EdrickOliveira/softstarter/README.md

# Soft Starter - V0.6.0
By Davi da Silva Schuch and Edrick Thomé de Oliveira \
Eletrônica de Potência e Processamento de Sinais - Prof. Irineu A. Ronconi Jr.

## Documentation and Progress
- [Zero Detector](docs/zeroDetector/) 
    - [Zero Detector Test](docs/zeroDetector/zeroDetector%20test/)
    - [Zero Detector Fix](docs/zeroDetector/zeroDetector%20fix/README.md) 
- [Trigger](docs/trigger/)
    - [Calculation](docs/trigger/triggerAngle%20calculation/README.md)
    - [Test](docs/trigger/triggerPulse%20test/README.md)
- [0.0.0-waveModulation](docs/0.0.0-waveModulation/README.md)
- [0.1.0-standardControl](docs/0.1.0-standardControl/README.md)
- [0.1.1-inductiveLayout](docs/0.1.1-inductiveLayout/README.md)
- [0.1.2-motorAtNeutral](docs/0.1.2-motorAtNeutral/README.md)
- [0.1.3-minecraftsLayout](docs/0.1.3-minecraftsLayout/README.md)
- [0.2.0-newTriac](docs/0.2.0-newTriac/README.md)
- [0.2.1-inductiveAgain](docs/0.2.1-inductiveAgain/README.md)
- [0.2.2-universalBack](docs/0.2.2-universalBack/README.md)
    - [extensionFixAttempt](docs/extensionFixAttempt/README.md)
- [0.2.3-pwm](docs/0.2.3-pwm/README.md)
- [0.3.0-setPowerRatio](docs/0.3.0-setPowerRatio/README.md)
- [0.3.1-speedRatio](docs/0.3.1-speedRatio/README.md)
- [0.3.2-loopMenu](docs/0.3.2-loopMenu/README.md)
- [0.4.0-rampSettings](docs/0.4.0-rampSettings/README.md)
- [0.4.1-softstarting](docs/0.4.1-softstarting/README.md)
- [0.5.0-currentMeasurement](docs/0.5.0-currentMeasurement/README.md)
- [0.5.1-ina226](docs/0.5.1-ina226/README.md)
- [0.5.2-currentTransformer](docs/0.5.2-currentTransformer/README.md)
- [0.5.3-alerts](docs/0.5.3-alerts/README.md)
- [0.5.4-overcurrentProtection](docs/0.5.4-overcurrentProtection/README.md)
- [0.6.0-phaseDetection](docs/0.6.0-phaseDetection/README.md)
