EdrickOliveira/softstarter/docs/0.4.1-softstarting/README.md

# softstarting

The "startRamp" function has been developed, so that the user can start the motor according to the ramps settings.

The console displays the current state (rising - full - falling - off).
