EdrickOliveira/softstarter/docs/0.3.2-loopMenu/README.md

# loopMenu

Now the menu is inside the while loop.

This version allows the user to set the Power Ratio sequentially, without having to restart the microcontroller.
