EdrickOliveira/softstarter/docs/0.1.1-inductiveLayout/Vae&Vde_0.JPG

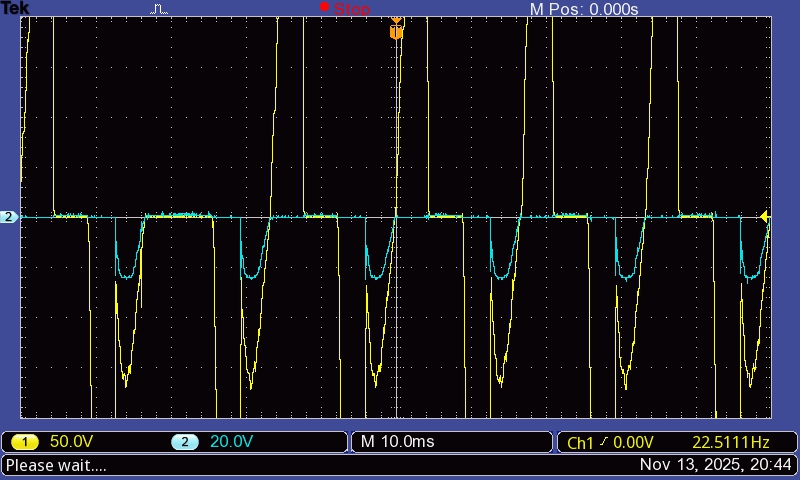
docs/0.1.1-inductiveLayout/Vae&Vde_0.JPG
