EdrickOliveira/softstarter/docs/0.1.1-inductiveLayout/Vae&Vde_1.JPG

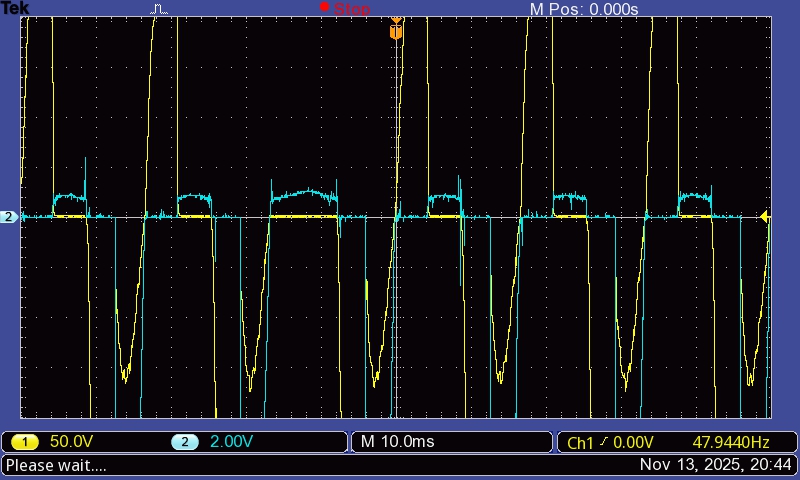
docs/0.1.1-inductiveLayout/Vae&Vde_1.JPG
