EdrickOliveira/softstarter/docs/0.1.1-inductiveLayout/Vmotor.JPG

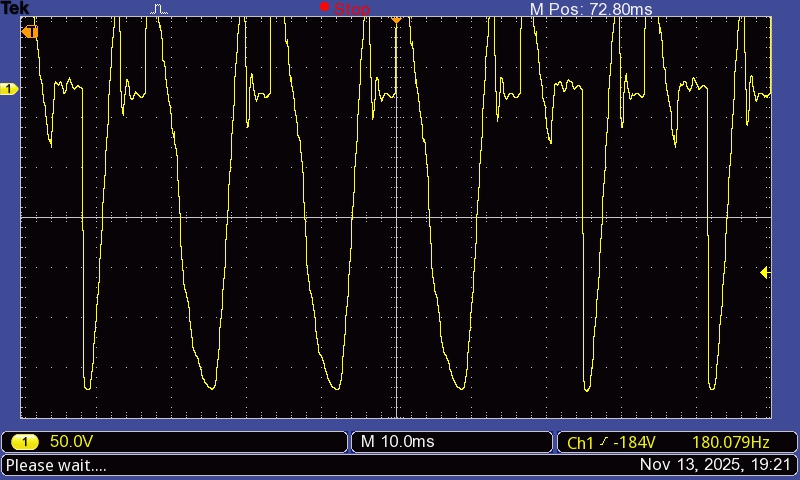
docs/0.1.1-inductiveLayout/Vmotor.JPG
