EdrickOliveira/softstarter/docs/0.2.1-inductiveAgain/Vae.JPG

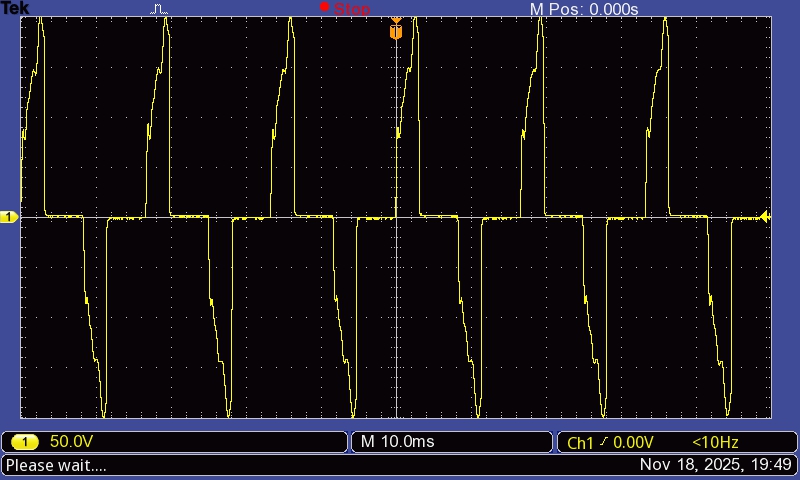
docs/0.2.1-inductiveAgain/Vae.JPG
