EdrickOliveira/softstarter/docs/0.2.1-inductiveAgain/Vra&Vea_0.JPG

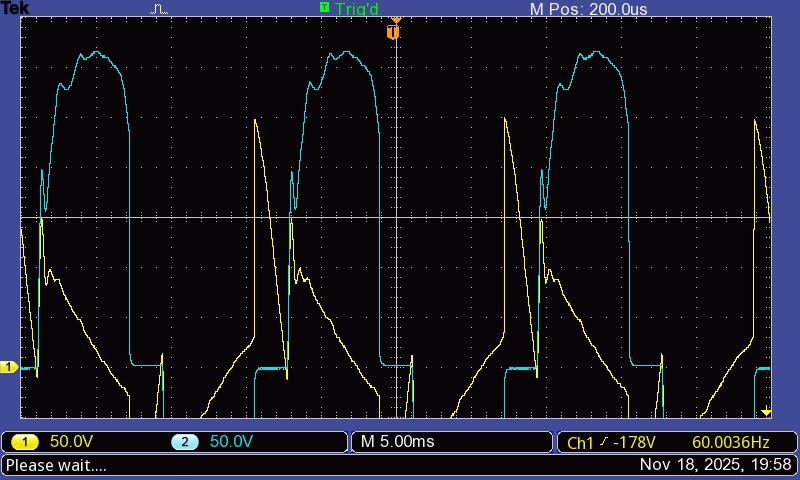
docs/0.2.1-inductiveAgain/Vra&Vea_0.JPG
