EdrickOliveira/softstarter/docs/0.2.1-inductiveAgain/Vra&Vea_1.JPG

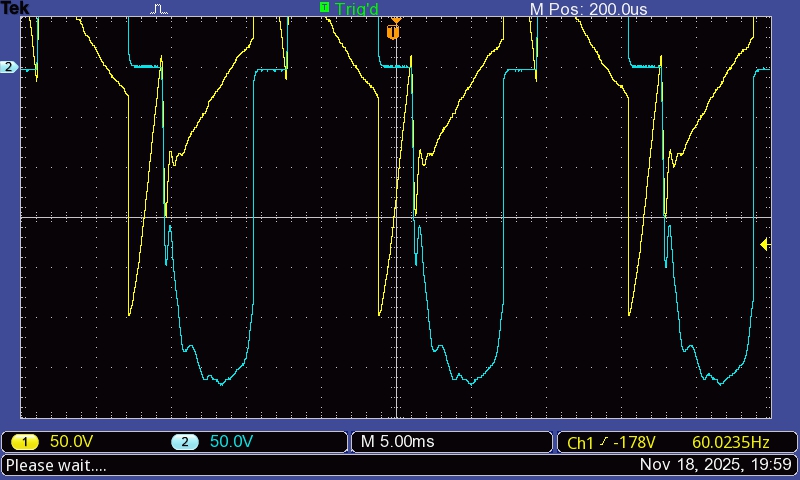
docs/0.2.1-inductiveAgain/Vra&Vea_1.JPG
