EdrickOliveira/softstarter/docs/0.2.1-inductiveAgain/Vra.JPG

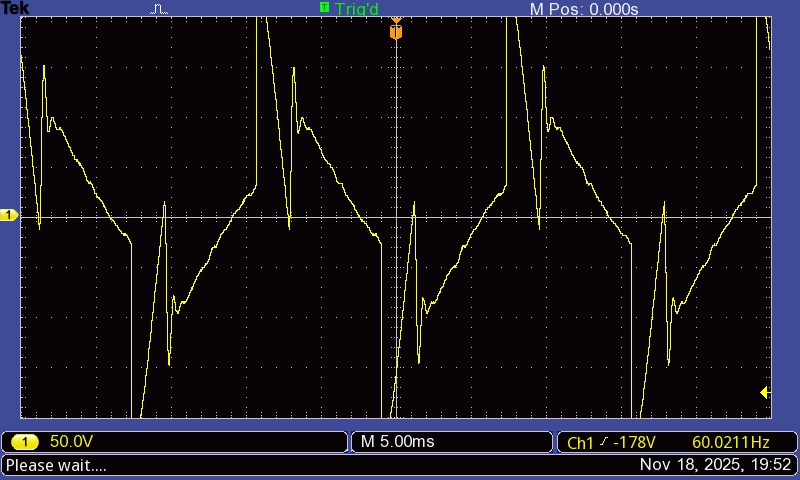
docs/0.2.1-inductiveAgain/Vra.JPG
