EdrickOliveira/softstarter/docs/0.2.3-pwm/pwmGap.JPG

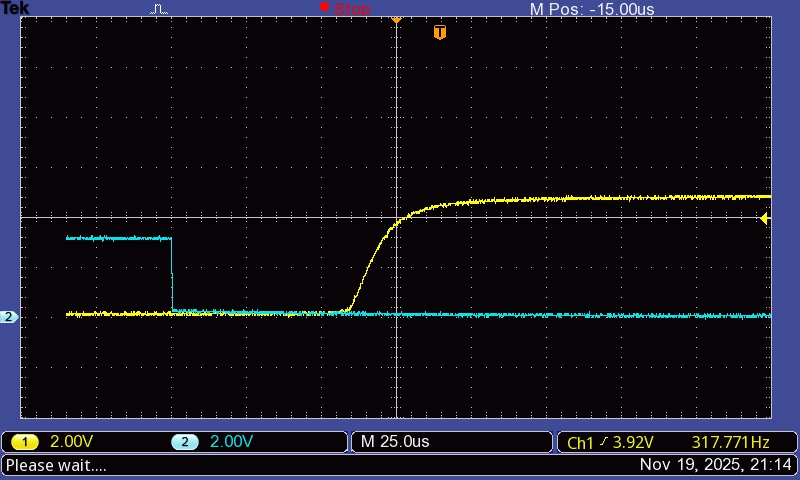
docs/0.2.3-pwm/pwmGap.JPG
