EdrickOliveira/softstarter/docs/0.2.3-pwm/pwmZoomIn.JPG

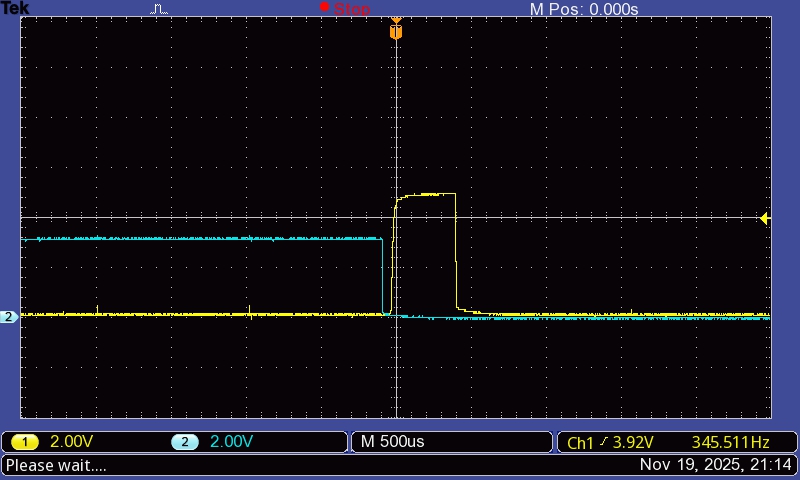
docs/0.2.3-pwm/pwmZoomIn.JPG
