EdrickOliveira/softstarter/docs/0.5.0-currentMeasurement/README.md

# currentMeasurement

In order to build the overcurrent protection circuit, the first step was to measure the current through the motor. The method used was with a shunt resistor:

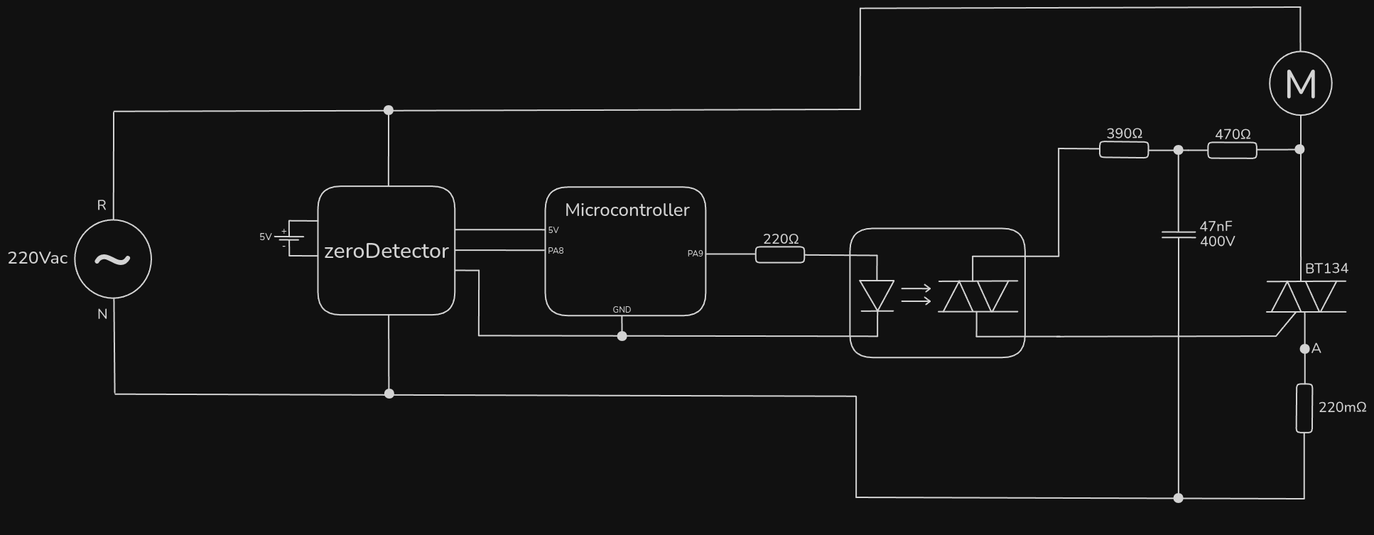
[picture p77: docs/0.5.0-currentMeasurement/diagram.png]


## Results

The $V_{AN}$ was measured for different $S_r$ values:

### $S_r=10\%$

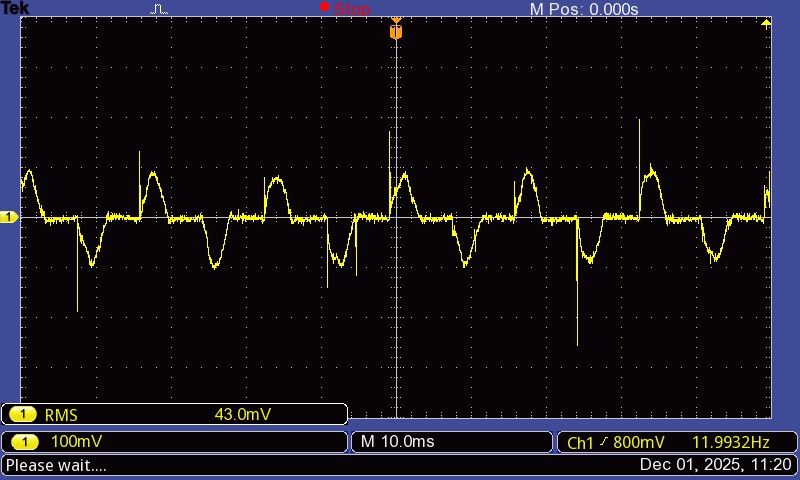
[picture p78: docs/0.5.0-currentMeasurement/Sr_10.JPG]


### $S_r=20\%$

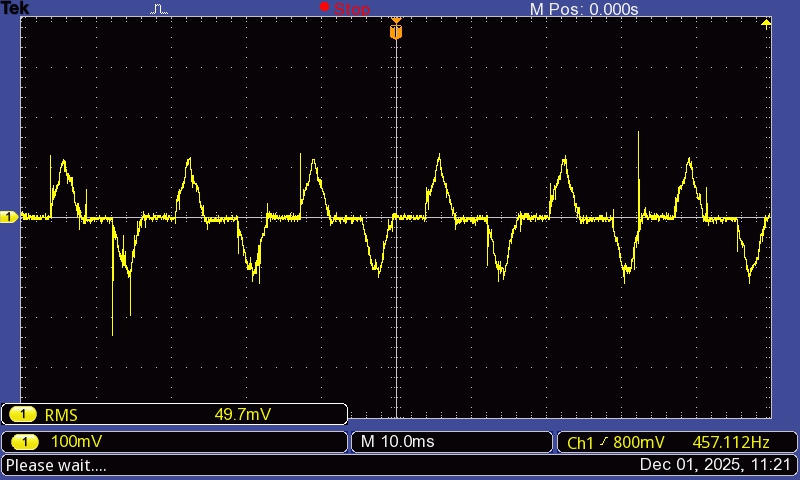
[picture p79: docs/0.5.0-currentMeasurement/Sr_20.JPG]


### $S_r=30\%$

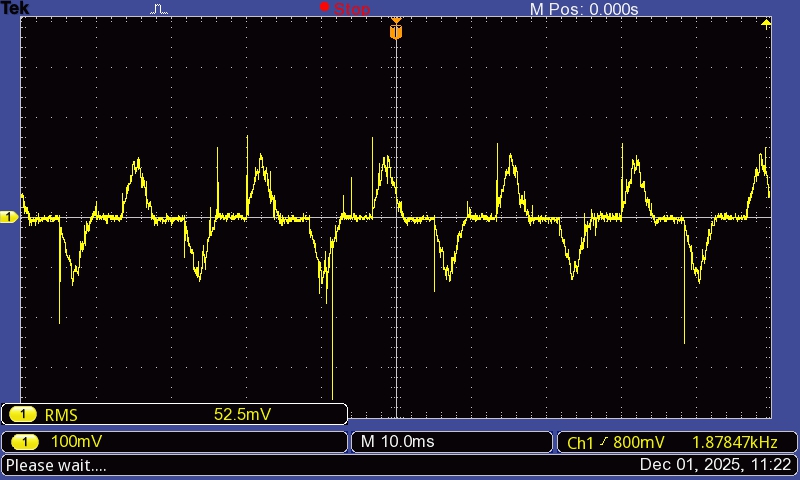
[picture p80: docs/0.5.0-currentMeasurement/Sr_30.JPG]


### $S_r=50\%$

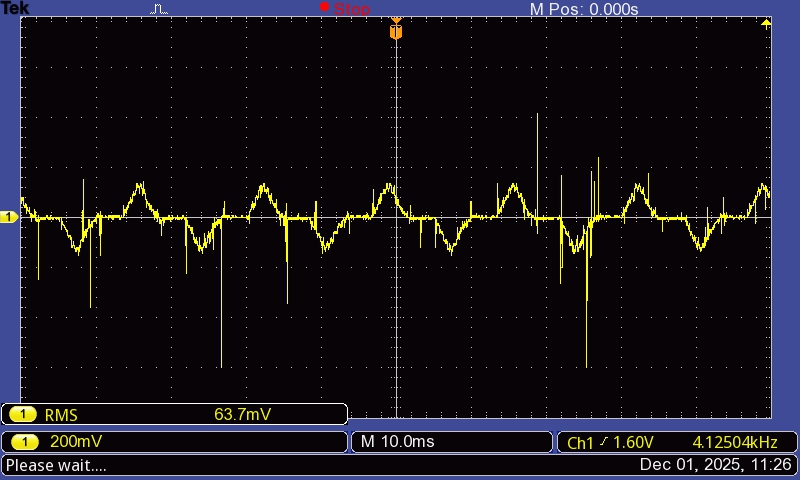
[picture p81: docs/0.5.0-currentMeasurement/Sr_50.JPG]


### $S_r=70\%$

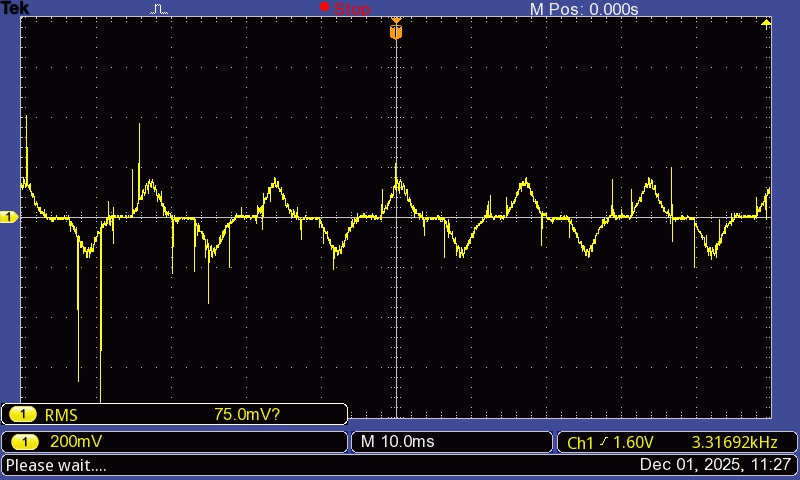
[picture p82: docs/0.5.0-currentMeasurement/Sr_70.JPG]


### $S_r=100\%$

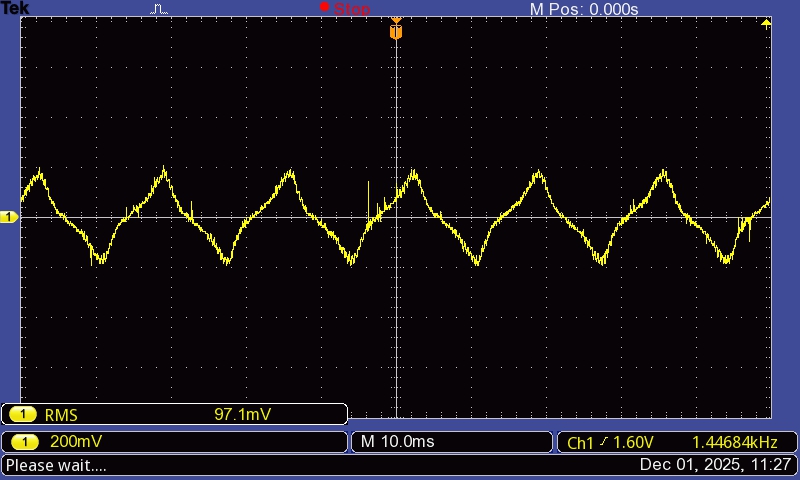
[picture p83: docs/0.5.0-currentMeasurement/Sr_100.JPG]


### $S_r=100\%; I=1.5I_{typ}$

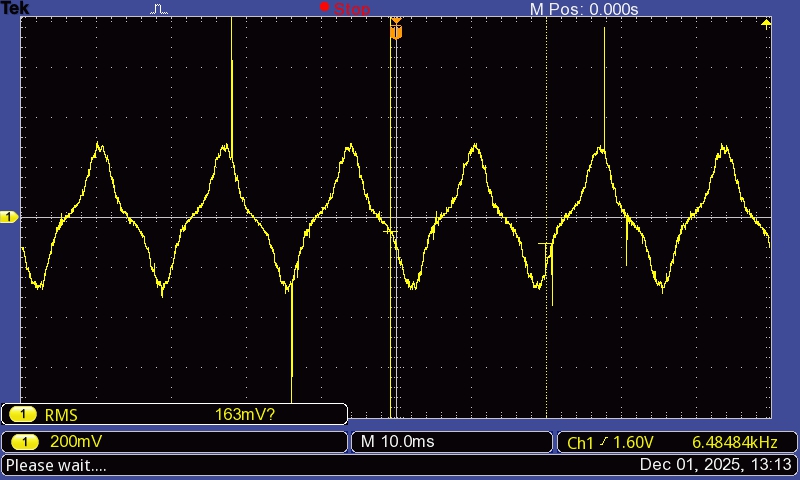
[picture p84: docs/0.5.0-currentMeasurement/1.5I.JPG]

$V_{shunt_{peak}}=360mV$

### $S_r=100\%; I=2I_{typ}$

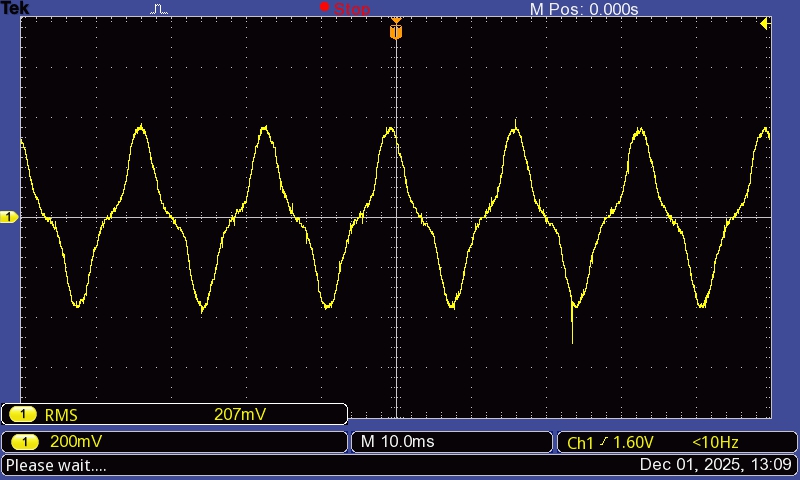
[picture p85: docs/0.5.0-currentMeasurement/2I.JPG]

$V_{shunt_{peak}}=280mV$

## Discussion

If we can measure the current discretely frequently enough, we can just check if it's greater than a desired threshold to take action.

The typical motor current is $500mA$. The system has to shut down if it's more than $1A$, or pull the trigger back if more than $750mA$ ($2\cdot I_{typ}$ ; $1.5\cdot I_{typ}$ - project criteria).
