EdrickOliveira/softstarter/docs/trigger/triggerPulse test/triggerPulse - zoom in.JPG

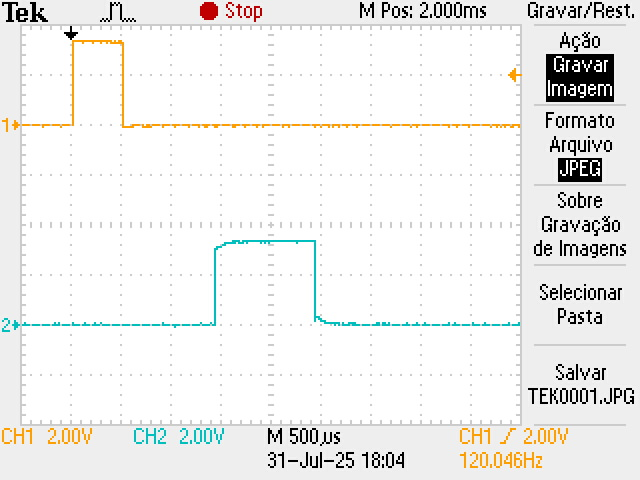
docs/trigger/triggerPulse test/triggerPulse - zoom in.JPG
