EdrickOliveira/softstarter/docs/trigger/triggerPulse test/triggerPulse - zoom out.JPG

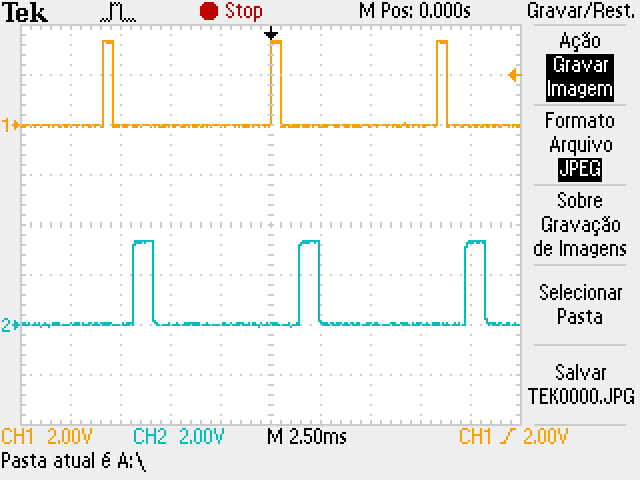
docs/trigger/triggerPulse test/triggerPulse - zoom out.JPG
