EdrickOliveira/softstarter/docs/zeroDetector/zeroDetector test/circuit.png

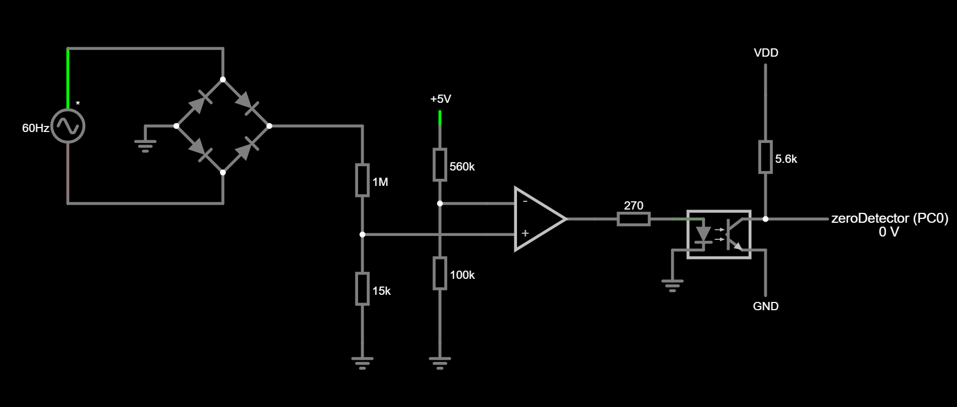
docs/zeroDetector/zeroDetector test/circuit.png
