EdrickOliveira/softstarter/docs/zeroDetector/zeroDetector test/pin (PC1).JPG

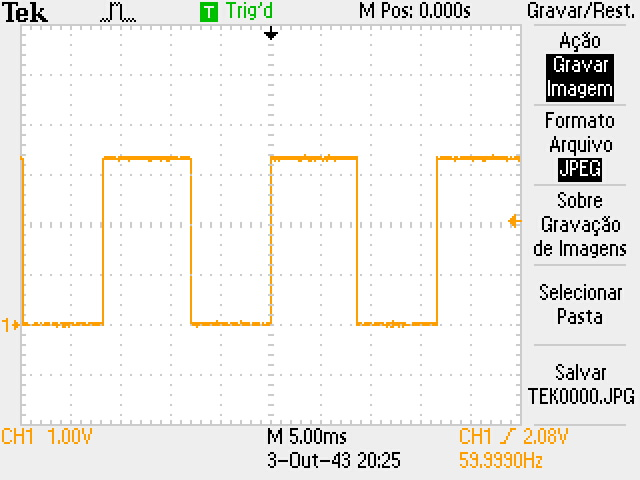
docs/zeroDetector/zeroDetector test/pin (PC1).JPG
