EdrickOliveira/softstarter/Core/Src/main.c

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
/* Includes ------------------------------------------------------------------*/
#include "main.h"

/* USER CODE BEGIN Includes */
#include "math.h"
#include "powerToAngle.h"
/* USER CODE END Includes */

/* USER CODE BEGIN PTD */
typedef struct{
	//rising and falling times in seconds
	int risingTime;
	int fallingTime;
}ramps_t;
/* USER CODE END PTD */

/* USER CODE BEGIN PD */
#define PULSE_WIDTH 1000	//pulse width in TIM1's clock pulses (ARR = 58100)
#define TRIGGER_ARR 58100
#define RX_BUFFER_SIZE 4
/* USER CODE END PD */

TIM_HandleTypeDef htim1;
TIM_HandleTypeDef htim10;
TIM_HandleTypeDef htim11;

UART_HandleTypeDef huart2;
DMA_HandleTypeDef hdma_usart2_rx;

/* USER CODE BEGIN PV */
ramps_t ramps;
uint32_t time_ms = 0;		//stopwatch

uint32_t triggerCCR;

uint8_t rx;				//byte received from UART
uint8_t rxBuffer[RX_BUFFER_SIZE];	//stores data received from UART
uint8_t rxFlag = 0;		//flips to 1 when DMA request is complete (a message has been received)
uint8_t inputSize;	//the size of the next expected input

uint8_t alertsEnabled = 0;
uint8_t alertFlag = 0;	// 0 = no alert; 1 = slow alert; 2 = stop alert
uint32_t stopAlertCounter = 0;
uint32_t slowAlertCounter = 0;

uint8_t phaseUp = 0;	//0 - phase is down/off; 1 - phase is up (220V)
/* USER CODE END PV */

void SystemClock_Config(void);
static void MX_GPIO_Init(void);
static void MX_DMA_Init(void);
static void MX_TIM1_Init(void);
static void MX_USART2_UART_Init(void);
static void MX_TIM10_Init(void);
static void MX_TIM11_Init(void);
/* USER CODE BEGIN PFP */
void menu();
void setPr();
void startRamp();
void rampSettings();
void setRampTime(int *rampTime);
void overcurrent();
void phaseDown();

void setTriggerCCR(uint32_t newTrigger);

void clearRxBuffer();
void appendRxBuffer(uint8_t data);
void backspaceRxBuffer();
char isInputComplete();
int extractNumber();	//convert the byte sequence buffer (number written in ASCII) to integer
void receiveInput(int size);

int len(uint8_t *s);	//returns the length of a string
/* USER CODE END PFP */

/**
  * @brief  The application entry point.
  * @retval int
  */
int main(void)
{

  /* MCU Configuration--------------------------------------------------------*/

  /* Reset of all peripherals, Initializes the Flash interface and the Systick. */
  HAL_Init();

  /* Configure the system clock */
  SystemClock_Config();

  /* Initialize all configured peripherals */
  MX_GPIO_Init();
  MX_DMA_Init();
  MX_TIM1_Init();
  MX_USART2_UART_Init();
  MX_TIM10_Init();
  MX_TIM11_Init();
  /* USER CODE BEGIN 2 */
  triggerCCR = TIM1->CCR2;	//initialize triggerCCR variable
  setTriggerCCR(TRIGGER_ARR);

  HAL_TIM_PWM_Start(&htim1, TIM_CHANNEL_2);	//start trigger PWM

  HAL_TIM_Base_Start_IT(&htim11);	//start phase detection

  //clear buffer and start listening to UART
  clearRxBuffer();
  HAL_UART_Receive_DMA(&huart2, &rx, 1);

  /* USER CODE END 2 */

  /* Infinite loop */
  /* USER CODE BEGIN WHILE */
  while (1)
  {
	  if(!alertFlag)			menu();			//go to menu if everything's alright
	  else if(alertFlag == 2)	overcurrent();	//overcurrent protocol if stopAlert triggers
    /* USER CODE END WHILE */

    /* USER CODE BEGIN 3 */
  }
  /* USER CODE END 3 */
}

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
/* USER CODE BEGIN 4 */
void menu(){
	uint8_t message[] = {"\r\n\nCommands:\n\r\t'P': set power ratio\n\r\t'S': start ramp\n\r\t'R': ramp settings\n\rType the command: "};

	HAL_UART_Transmit(&huart2, message, len(message), HAL_MAX_DELAY);	//print menu and prompt
	receiveInput(1);	//1 byte long input expected

	switch(rxBuffer[0]){
	case 'p':
		setPr();
		break;
	case 's':
		startRamp();
		break;
	case 'r':
		rampSettings();
		break;
	}
}

void setPr(){
	uint8_t message[] = {"\r\n\nInsert desired Power Ratio (in percentage): "};
	float Pr, Sr, triggerAngle;
	uint16_t triggerCCR;

	HAL_UART_Transmit(&huart2, message, len(message), HAL_MAX_DELAY);	//print prompt
	receiveInput(3);	//3 bytes long input expected

	Sr = (float)extractNumber()/100;
	Pr = speedToPower(Sr);
	triggerAngle = getTrigger(Pr);
	triggerCCR = (uint16_t)angleToCCR(triggerAngle, TRIGGER_ARR);
	setTriggerCCR(triggerCCR);
}

void startRamp(){
	uint8_t risingMsg[] = {"\r\n\nRising ramp started"};
	uint8_t fullPowerMsg[] = {"\r\nFull power\r\nType 'enter' to start falling ramp"};
	uint8_t fallingMsg[] = {"\r\nFalling ramp started"};
	uint8_t offMsg[] = {"\r\nMotor is off"};
	float Pr, Sr, triggerAngle, time_s;
	uint16_t triggerCCR;

	HAL_UART_Transmit(&huart2, risingMsg, len(risingMsg), HAL_MAX_DELAY);	//print that rising has begun

	alertsEnabled = 1;	//enable overcurrent alerts

	//rising ramp
	HAL_TIM_Base_Start_IT(&htim10);	//start stopwatch
	do{
		//execute phase down protocol
		if(!phaseUp){
			phaseDown();
			return;
		}

		time_s = ((float)(time_ms))/1000;

		//constantly update trigger angle according to the stopwatch, if there is no active alert
		if(!alertFlag){
			Sr = ((float)time_s)/ramps.risingTime;	//percentage of time elapsed (100% is the rising time) is the SpeedRatio
			Pr = speedToPower(Sr);
			triggerAngle = getTrigger(Pr);
			triggerCCR = (uint16_t)angleToCCR(triggerAngle, TRIGGER_ARR);
			setTriggerCCR(triggerCCR);
		}
		//slow down (go back in time) if slowAlert triggers
		else if(alertFlag == 1){
			if(time_ms-200*ramps.risingTime >= 0)	time_ms -= 200*ramps.risingTime;
			else									time_ms = 0;
			alertFlag = 0;
		}
		//execute overcurrent protocol if stopAlert triggers
		else if(alertFlag==2){
			return;
		}
	}while(time_s<ramps.risingTime);	//stop when rising time is complete
	HAL_TIM_Base_Stop_IT(&htim10);
	time_ms = 0;

	HAL_UART_Transmit(&huart2, fullPowerMsg, len(fullPowerMsg), HAL_MAX_DELAY);	//print full power indicator
	receiveInput(1);	//wait for any user input

	if(alertFlag == 2){
		return;
	}

	HAL_UART_Transmit(&huart2, fallingMsg, len(fallingMsg), HAL_MAX_DELAY);	//print that falling has begun

	//falling ramp
	HAL_TIM_Base_Start_IT(&htim10);	//start stopwatch
	do{
		//execute phase down protocol
		if(!phaseUp){
			phaseDown();
			return;
		}

		time_s = ((float)(time_ms))/1000;

		//constantly update trigger angle according to the stopwatch
		Sr = ((float)(ramps.fallingTime-time_s))/ramps.fallingTime;	//percentage of time remaining to falling time is the SpeedRatio
		Pr = speedToPower(Sr);
		triggerAngle = getTrigger(Pr);
		triggerCCR = (uint16_t)angleToCCR(triggerAngle, TRIGGER_ARR);
		setTriggerCCR(triggerCCR);
	}while(time_s<ramps.fallingTime);
	HAL_TIM_Base_Stop_IT(&htim10);
	time_ms = 0;

	HAL_UART_Transmit(&huart2, offMsg, len(offMsg), HAL_MAX_DELAY);	//print that motor is off

	alertsEnabled = 0;	//disable overcurrent alerts
}

void rampSettings(){
	uint8_t message[] = {"\r\n\nRising ramp ('R')\n\rFalling ramp ('F')\n\rSelect an option: "};

	HAL_UART_Transmit(&huart2, message, len(message), HAL_MAX_DELAY);
	receiveInput(1);	//1 byte long input expected

	switch(rxBuffer[0]){
	case 'r':
		setRampTime(&(ramps.risingTime));
		break;
	case 'f':
		setRampTime(&(ramps.fallingTime));
		break;
	}
}

void setRampTime(int *rampTime){
	uint8_t message[] = {"\r\nInsert ramp time in seconds (max 3 digits): "};

	HAL_UART_Transmit(&huart2, message, len(message), HAL_MAX_DELAY);
	receiveInput(3);	//3 bytes long input expected

	*rampTime = extractNumber();
}

void overcurrent(){
	uint8_t overcurrentMsg[] = {"\r\nOvercurrent - process aborted"};

	setTriggerCCR(TRIGGER_ARR);	//turn motor off
	HAL_TIM_Base_Stop(&htim10);	//turn ramp timer off
	time_ms = 0;				//reset ramp time counter

	HAL_UART_Transmit(&huart2, overcurrentMsg, len(overcurrentMsg), HAL_MAX_DELAY);	//print overcurrent message

	alertFlag = 0;		//reset stopAlert flag
	alertsEnabled = 0;	//disable overcurrent alerts
}

void phaseDown(){
	uint8_t phaseDownMsg[] = {"\r\nPhase down - process aborted"};

	setTriggerCCR(TRIGGER_ARR);	//turn motor off
	HAL_TIM_Base_Stop(&htim10);	//turn ramp timer off
	time_ms = 0;				//reset ramp time counter

	HAL_UART_Transmit(&huart2, phaseDownMsg, len(phaseDownMsg), HAL_MAX_DELAY);	//print overcurrent message

	alertFlag = 0;		//reset stopAlert flag
	alertsEnabled = 0;	//disable overcurrent alerts
}

void setTriggerCCR(uint32_t newTrigger){
	TIM1->CCR2 = newTrigger;
	triggerCCR = newTrigger;
}

void clearRxBuffer(){
	for(int i=0; i<RX_BUFFER_SIZE; i++){
		rxBuffer[i] = '\0';
	}
}

void appendRxBuffer(uint8_t data){
	int i=0;

	while(rxBuffer[i]!='\0'){
		i++;
		if(i==RX_BUFFER_SIZE)	return;	//do nothing if buffer is full
	}

	rxBuffer[i] = rx;
}

void backspaceRxBuffer(){
	uint8_t skipLine[] = {"\r\n"};

	int i;

	for(i=RX_BUFFER_SIZE; rxBuffer[i]=='\0'; i--);	//run from end to front in the buffer up to the last character

	rxBuffer[i] = '\0';	//delete the last character in buffer

	//print rxBuffer in next line
	HAL_UART_Transmit(&huart2, skipLine, len(skipLine), HAL_MAX_DELAY);
	i = 0;
	while(rxBuffer[i]!='\0'){
		HAL_UART_Transmit(&huart2, &rxBuffer[i], 1, HAL_MAX_DELAY);
		i++;
	}
}

char isInputComplete(){
	int i=0;

	while(rxBuffer[i]!='\0'){
		i++;
		if(i==inputSize)	return 'c';	//return that input is complete (true)
	}

	return '\0';	//if there are bytes remaining, return false
}

int extractNumber(){
	int num = 0, exponent = 0, i=RX_BUFFER_SIZE-1;

	//run from end to start in the buffer, until data is found
	while(rxBuffer[i]=='\0'){
		i--;
	}

	for(i=i; i>=0; i--){
		num += (rxBuffer[i]-'0')*pow(10, exponent);
		exponent++;
	}

	return num;
}

void receiveInput(int size){
	clearRxBuffer();
	inputSize = size;	//'size' byte long input expected

	//wait for an input
	while(!rxFlag){
		//exit if there's an overcurrent alert or the phase goes down
		if(alertsEnabled && (alertFlag == 2 || !phaseUp))	return;
	}
	rxFlag = 0;
}

int len(uint8_t *s){
	int size = 0;

	while(*s != '\0'){
		size++;
		s++;
	}

	return size;
}

void HAL_UART_RxCpltCallback(UART_HandleTypeDef *huart){
	if(rx!='\177'){
		HAL_UART_Transmit(huart, &rx, 1, HAL_MAX_DELAY);	//echo if key typed was not backspace/del
	}
	//allow user to delete last character, if they typed backspace/del
	else{
		backspaceRxBuffer();
		return;
	}

	//flip flag if user typed 'enter'
	if(rx=='\r'){
		rxFlag++;
		return;
	}

	appendRxBuffer(rx);

	//flip flag when input has been completely received
	if(isInputComplete())	rxFlag++;
}

void HAL_TIM_PeriodElapsedCallback(TIM_HandleTypeDef *htim){
	if(htim->Instance == TIM10){
		time_ms++;	//increment stopwatch by 1 milisecond
	}
	if(htim->Instance == TIM11){
		//decrement phase checking variable. It will be set back to 10 if phase is up. Otherwise it'll eventually become zero, meaning the phase is down
		phaseUp--;
		if(phaseUp == 0xFF)	phaseUp = 0;	//avoid underflow
	}
}

void HAL_GPIO_EXTI_Callback(uint16_t GPIO_Pin){
	//reinforce that phase is up
	if(GPIO_Pin == phaseDetector_Pin){
		phaseUp = 10;
	}

	if(stopAlertCounter || slowAlertCounter || !alertsEnabled)	return;	//ignore alerts if there is already one being processed, or they are disabled

	//alert detection and debouncing

	if(GPIO_Pin == alertStop_Pin){
		while(!HAL_GPIO_ReadPin(GPIOA, alertStop_Pin)){	//if the alert stays valid (active in LOW) for an amount of time
			stopAlertCounter++;
			if(stopAlertCounter>100000){
				stopAlertCounter = 0;
				alertFlag = 2;							//then trigger the alert
				return;
			}
		}
		stopAlertCounter = 0;							//if there is a rising edge at any moment, ignore and reset alert
	}

	if(GPIO_Pin == alertSlow_Pin){
		while(!HAL_GPIO_ReadPin(GPIOA, alertSlow_Pin)){
			slowAlertCounter++;
			if(slowAlertCounter>100000){
				slowAlertCounter = 0;
				alertFlag = 1;
				return;
			}
		}
		slowAlertCounter = 0;
	}
}
/* USER CODE END 4 */
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
