EdrickOliveira/softstarter/(commit log)

2025-07-17 feat: add CubeIDE project files
    The .ioc version is not the old one, thus it's not compatible with Schuch's laptop
    [main.c, softstarter.ioc]
2025-07-17 feat: zeroDetector
    The signal from the zeroDetector circuit was input to the STM32.
    Each pulse of the detector flips the state of the "signal" pin. The expected waveform of "signal" would be a square wave of 60Hz, as the zeroDetector pulse has a 120Hz and it takes two of them for a period of "signal". Its pin has been analysed, and the expected waveform, verified.
    The "signal" pin measurement and circuit of the zeroDetector are availiable in "assets\zeroDetector test".
    [main.c, softstarter.ioc]
2025-07-17 fix: "signal" pin
    The file name was displaying the wrong pin of "signal".
2025-07-31 feat: triggerPulse
    In the softstarter, a pulse should occur in sync with the zeroDetector, but with phase/delay.
    This simulates a zero detector signal through TIM10's PWM channel, which triggers TIM1's output compare to start.
    The circuit schematics and scope screenshot (results) are attached in "assets/triggerPulse test".
    The initial CCR2 value of TIM1 determines the phase between the zero detector and the trigger pulse, thus controling the average voltage. In this example, it's set to 1.43ms (10000 ticks) after zero detector's rising edge.
    The difference between the second and initial CCR2 value sets the trigger pulse width. In this example, it's set to 1ms (7000 ticks).
2025-08-07 feat: triggerPulse & zeroDetector
    Merge both commits by using the real zeroDetector signal to enable the trigger timer (TIM1's OC channel), instead of a PWM simulation (as done in triggerPulse).
    The trigger was transmitted through a solid-state relay (SSR) to the gate of a triac with a load, effectively cropping the supply wave and controling power to the load.
2025-08-20 revert: back to CubeIDE oriented organization
    [main.c]
2025-11-06 docs: upload STM32 Reference Manual
2025-11-13 0.1.0-feat: standardControl
    This is the first time the motor is used. The wave modulation of the last version was applied to an AC source with the motor as the load.
2025-11-14 docs: add schematic source
2025-11-17 0.1.2-feat: motorAtNeutral
2025-11-21 0.2.3-feat: pwm
2025-12-01 0.5.0-test: currentMeasurement
2025-12-02 0.5.2-feat: currentTransformer
2025-12-03 docs: add phaseDetection schematics
